coxoto/3dprint-x/non-print-parts/配件采购清单v3.0.xlsx

 | 零件 | 数量 | 备注 | 购买链接 | 单价 | 总价
型材 | 欧标2040V槽 8cm | 2 | 打孔情况查图片 | https://detail.tmall.com/item.htm?id=645296818131 |  | 40
 | 欧标2040V槽 14cm | 1 | 打孔情况查图片
 | 欧标2040V槽 16cm | 3 | 打孔情况查图片
 | 欧标2020V槽 16cm | 1 | 打孔情况查图片
 | 欧标2020V槽 8cm | 1
 |  |  |  |  |  | 0
型材配件 | 欧标2040V槽 内置角槽 | 2 |  | https://detail.tmall.com/item.htm?id=619268994329 | 1.3 | 2.6
 | 欧标2040V槽 带突起90度直角连接件 | 1 |  | https://detail.tmall.com/item.htm?id=619270997246 | 2 | 2
 |  |  |  |  |  | 0
线轨 | mgn12 轨道 25cm | 1 |  | https://item.taobao.com/item.htm?id=570924265589 | 21 | 21
 | mgn9 轨道 25cm | 3 |  |  | 21 | 63
 | 滑块 mgn12c | 1 |  |  | 15 | 15
 | 滑块 mgn 9c | 2 |  |  | 14 | 28
 | 滑块 mgn 9h | 1 |  |  | 16 | 16
 |  |  |  |  |  | 0
3d打印机专用 | 同步带 GT2-6mm 2米 | 1 | 61cm + 62cm | https://item.taobao.com/item.htm?id=570390971772 | 4.55 | 4.55
 | 加热棒 | 1 | 12V50W出口版 | https://item.taobao.com/item.htm?id=570370525400 | 5.65 | 5.65
 | 温感（3950热头打印头热床测温电阻） | 1 | 1米线长 xh2.54端子（28号线） | https://item.taobao.com/item.htm?id=570755267450 | 2 | 2
 | 铁氟龙管（1米） | 1 | 乳白色2*4(1.75mm) | https://item.taobao.com/item.htm?id=570795285538 | 1.2 | 1.2
 | 带齿同步轮 | 2 | 普通版m3（20齿高16)内孔5mm | https://item.taobao.com/item.htm?id=570468538209 | 1.58 | 3.16
 | 喉管散热片 | 1 |  | https://item.taobao.com/item.htm?id=594763596247 | 3.5 | 3.5
 | 喉管 | 1 |  | https://item.taobao.com/item.htm?id=601375968132 | 1.8 | 1.8
 | 加热块 | 1 |  | https://item.taobao.com/item.htm?id=570977277989 | 1.7 | 1.7
 | 喷嘴 | 1 | 0.3/1.75mm | https://item.taobao.com/item.htm?id=570346885706 |  | 0
 | 气动直通快接头 | 1 | PC4-01带蓝色卡扣（直通） | https://item.taobao.com/item.htm?id=572400928067 | 0.74 | 0.74
 | 黄色强力弹簧 | 4 |  | https://item.taobao.com/item.htm?id=587615069560 | 0.84 | 3.36
 | x支架 | 1 | 热床支架不带滑轮 | https://item.taobao.com/item.htm?id=646674554829 | 31.8 | 31.8
 | 热床带线带温感 | 1 | 150*150热床12V带线带螺丝 | https://item.taobao.com/item.htm?id=609361349866 | 30.8 | 30.8
 | 法兰轴承（当惰轮） | 4 | F623ZZ（3*10*4） | https://item.taobao.com/item.htm?id=574092180169 | 0.75 | 3
 | Titan泰坦挤出机 | 1 | 不带电机 | https://item.taobao.com/item.htm?id=576967896210 | 19 | 19
 | 弹性联轴器 | 1 | 5mm*8mm*25mm | https://item.taobao.com/item.htm?id=570564051068 | 2.6 | 2.6
 | 丝杆+螺母 | 1 | 250mm（丝杆+螺母） | https://item.taobao.com/item.htm?id=573812002249 | 7.9 | 7.9
 | 微动开关 限位开关 | 1 | 【记得买个三孔xh2.54的线】 | https://item.taobao.com/item.htm?id=572130975483 | 0.3 | 0.3
 | 橡皮脚垫 | 4 | 20*14*17 | https://detail.tmall.com/item.htm?id=592188833539 | 0.25 | 1
 |  |  |  |  |  | 0
风扇 | 3010风扇 | 1 | 12V液压轴承8000转速[居中款XH2.54插头] | https://item.taobao.com/item.htm?id=611631396007 |  | 0
 | 3010涡轮风扇 | 1 | 含油轴承12V 2线(XH2.54插头) | https://item.taobao.com/item.htm?id=612218746821 | 6 | 6
 |  |  |  |  |  | 0
其它大件 | Makerbase MKS Gen-L 主板 | 1 | MKS GEN_L 2.1 | https://item.taobao.com/item.htm?id=543608919100 | 100 | 100
 | 12864 屏幕 | 1 |  | https://item.taobao.com/item.htm?id=651635691903 | 46 | 46
 | 电机驱动2209 | 2 |  | https://item.taobao.com/item.htm?id=596848801805 | 18 | 36
 | 电机驱动2208 | 2 |  | https://item.taobao.com/item.htm?id=560642031320 | 14 | 28
 | 42步进电机 | 4 |  | https://item.taobao.com/item.htm?id=608923027875 | 29 | 116
 | 12v开关电源 | 1 | S-200-12 / 12v 16.5A | https://detail.tmall.com/item.htm?id=613571195909 | 36 | 36
 | 插座带开关 | 1 | AC-01A三脚带灯 | https://item.taobao.com/item.htm?id=45556198869 | 2.5 | 2.5
 |  |  |  |  | 总计 | 682.16
其它耗材 | m3 沉头螺丝 32mm | 4
 | m3 黄铜滚花螺母 5mm高 5mm直径 | 20
 | m3 22mm | 2
 | m3 螺母 | 50+
 | m3 t型螺母 | 50+
 | m3 滑块螺母 | 50+
 | m3 6mm | 50+
 | m3 8mm | 50+
 | m3 12mm | 50+
 | m3 10mm | 50+
 | m3 金属垫片
 | m3 尼龙垫片
 | m3 尼龙柱 2mm | 4
 | m5 10mm | 8
 | m5 15mm | 3
 | 一些延长的电线
 | 热缩管
 | 耐热胶带
 | 隔热海绵
 | 打印板（普通/PEI/玻璃/晶格）
