coxoto/3dprint-x/non-print-parts/4020-holes.jpg

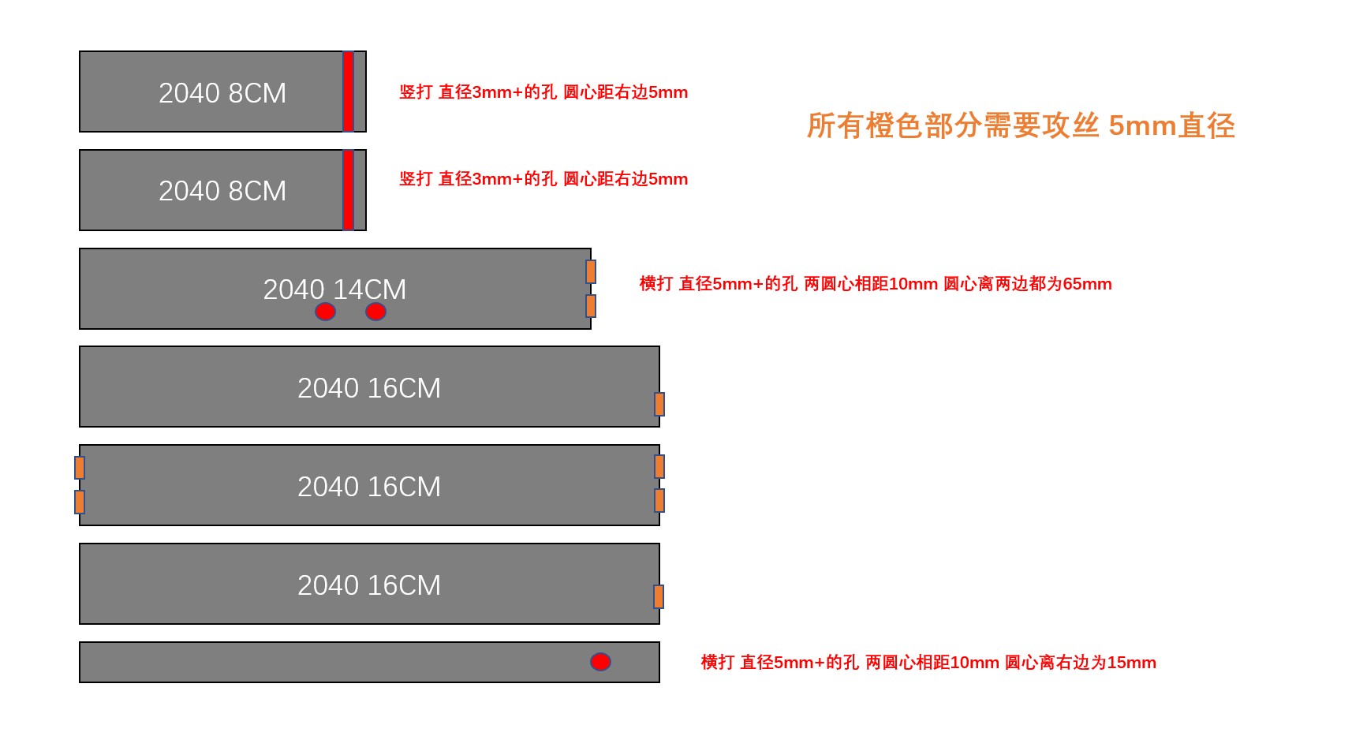
non-print-parts/4020-holes.jpg
