coxoto/3dprint-x/stl/1x main-heat-sink-support.stl

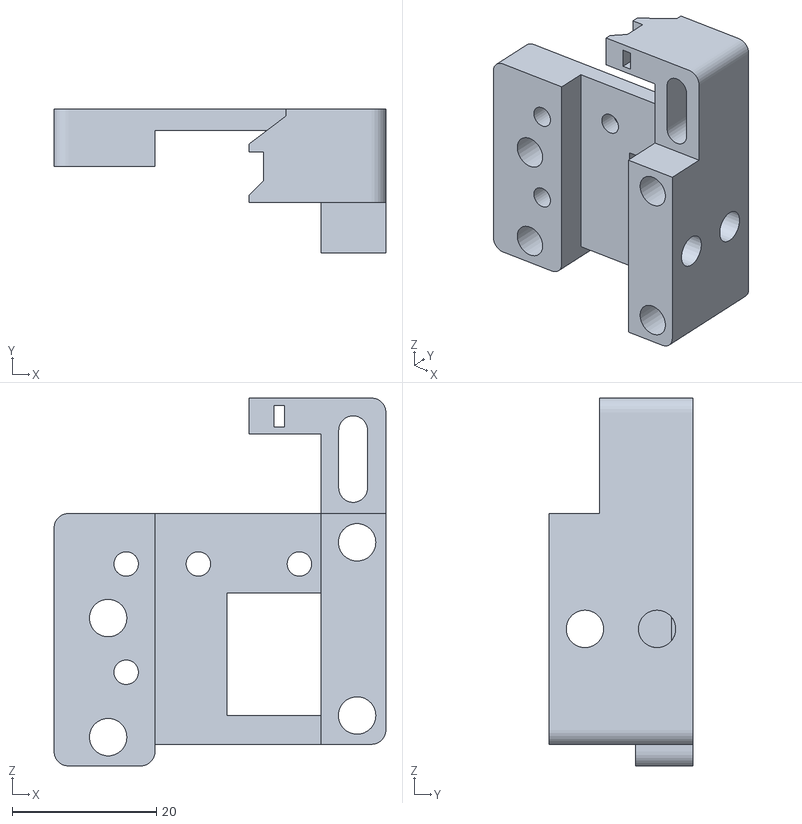
[picture p7: CAD file, 2021-11-16]
stl/1x main-heat-sink-support.stl
46.0 x 20.0 x 51.0
