coxoto/3dprint-x/stl/1x main-support.stl

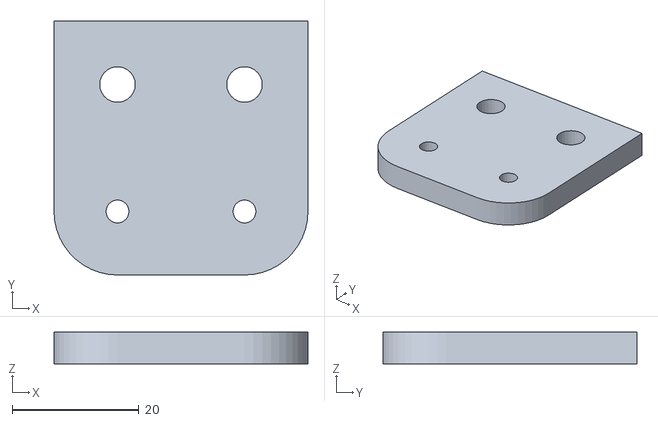
[picture p8: CAD file, 2021-11-16]
stl/1x main-support.stl
40.0 x 40.0 x 5.00
