coxoto/3dprint-x/design/00-全组装图.FCStd

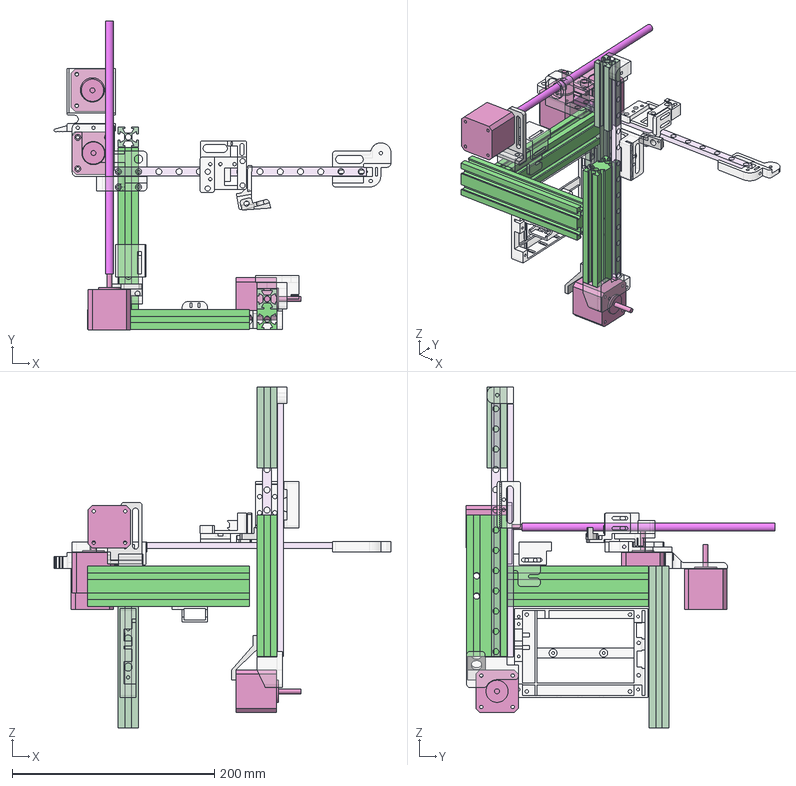
[picture p9: CAD file, 2021-11-23]
design/00-全组装图.FCStd
333.0 x 305.2 x 336.8 mm
x轴末端
小滑轨
42电机
挤出机支架
42电机002
mid主支架
mid主支架02
冷却支架02
冷却支架01
x-middle
xz核心件
2040 竖
y轴4线连接器
z下端
z轴限位架子
z电机板子
丝杆
42电机001
2040 140mm
小滑轨001
小滑轨002
Y电机支架
Y电机支架反面
new_y_end
中部热床支架支架
42电机003
主板架、
