coxoto/3dprint-x/stl/1x x-core.stl

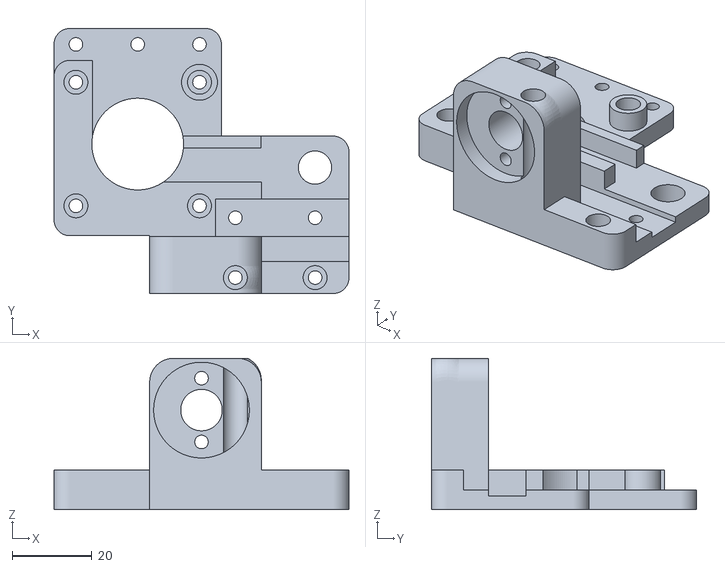
[picture p10: CAD file, 2021-11-23]
stl/1x x-core.stl
74.0 x 66.5 x 38.0
