coxoto/3dprint-x/stl/small-parts/4x big-knob.stl

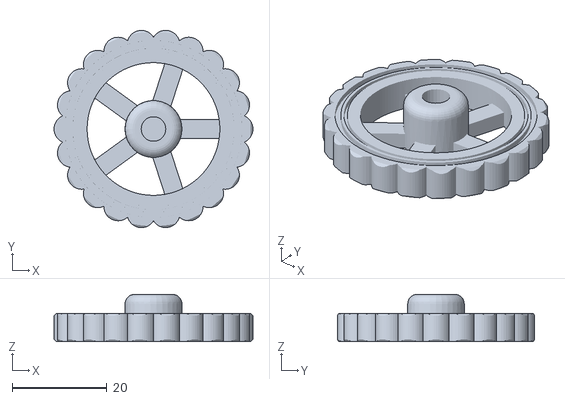
[picture p11: CAD file, 2021-11-23]
stl/small-parts/4x big-knob.stl
42.0 x 41.6 x 10.0
