coxoto/3dprint-x/design/00-其它小零件.FCStd

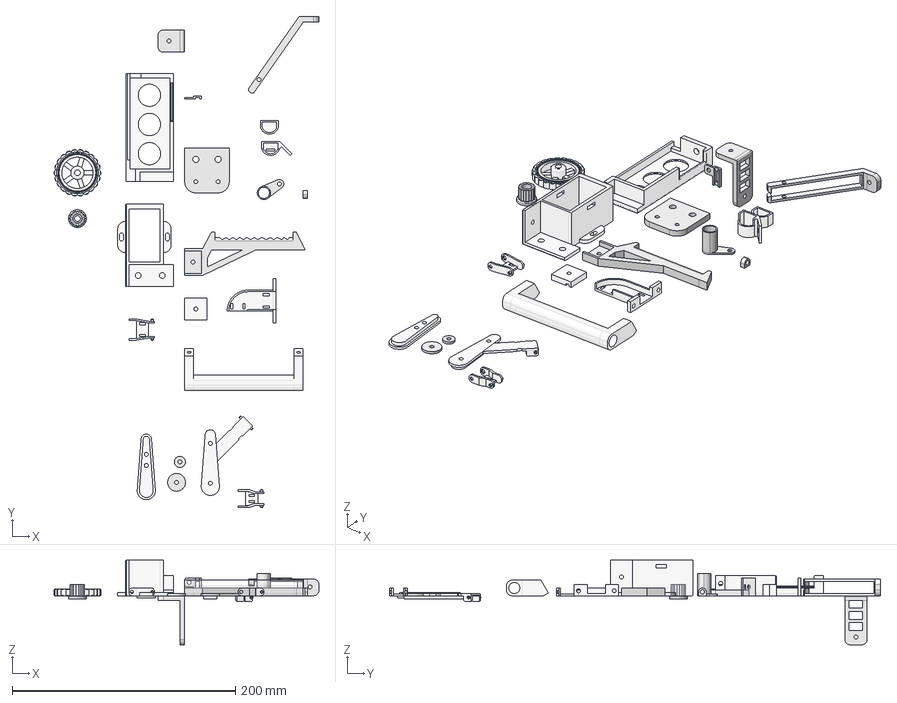
[picture p12: CAD file, 2021-11-23]
design/00-其它小零件.FCStd
237.3 x 439.8 x 76.0 mm
电源保护
开关盒
4孔骨架
三角料架
加固支架
小线槽
铁丝导料支架
尾巴线01
尾巴线02
灯管架01
灯管架02
新把手
导料滚轮支架
大链条（弃用）
主板转弯线束
大旋钮
小旋钮
热床卡口-零件01
热床卡口-零件02
8mm小圆
5mm小圆
小链条
热床卡口测试片
