coxoto/3dprint-x/stl/1x y-motor-support-2.stl

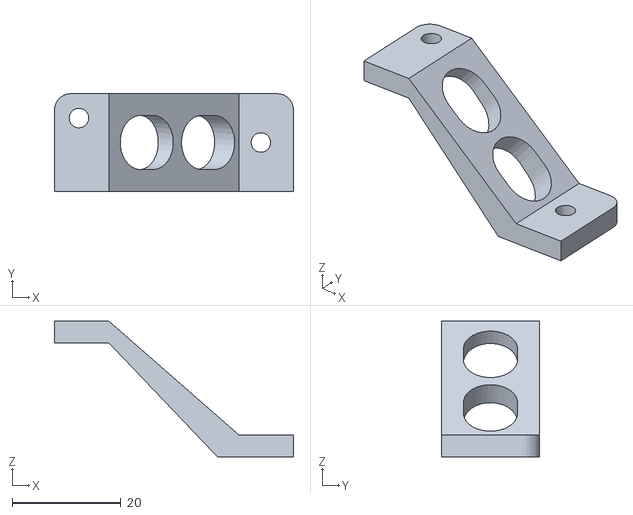
[picture p13: CAD file, 2021-11-18]
stl/1x y-motor-support-2.stl
44.0 x 18.0 x 25.0
