coxoto/3dprint-x/stl/small-parts/1x bed-middle-small-part.stl

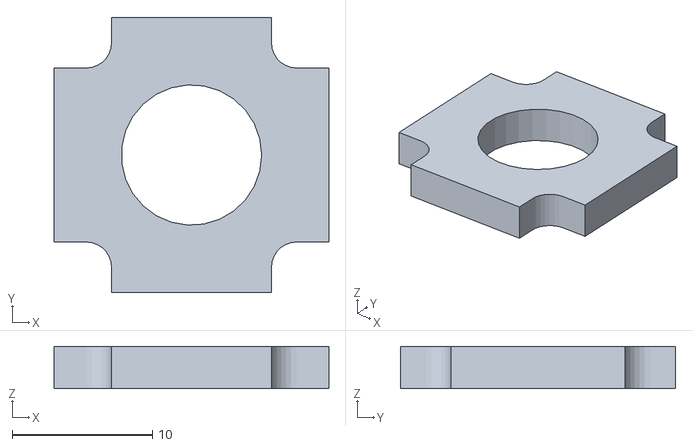
[picture p14: CAD file, 2021-11-16]
stl/small-parts/1x bed-middle-small-part.stl
19.6 x 19.6 x 3.00
