coxoto/3dprint-x/stl/1x x-mid.stl

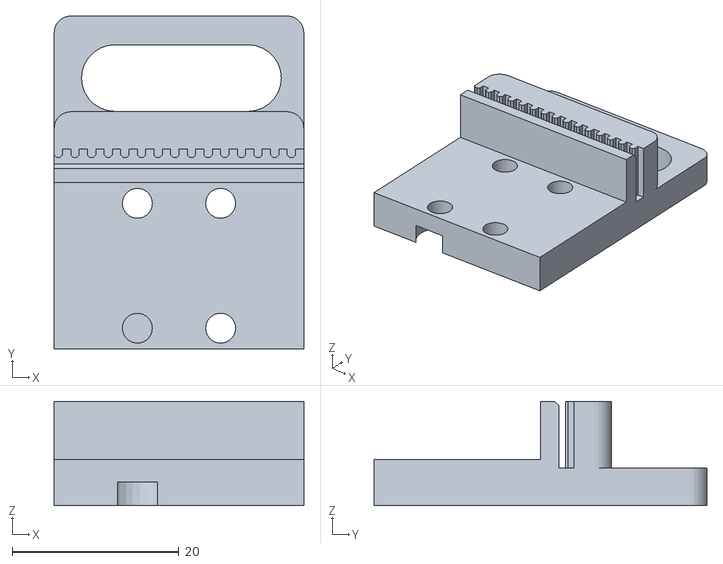
[picture p15: CAD file, 2021-11-18]
stl/1x x-mid.stl
30.0 x 40.0 x 12.5
