coxoto/3dprint-x/stl/small-parts/8x small-chain.stl

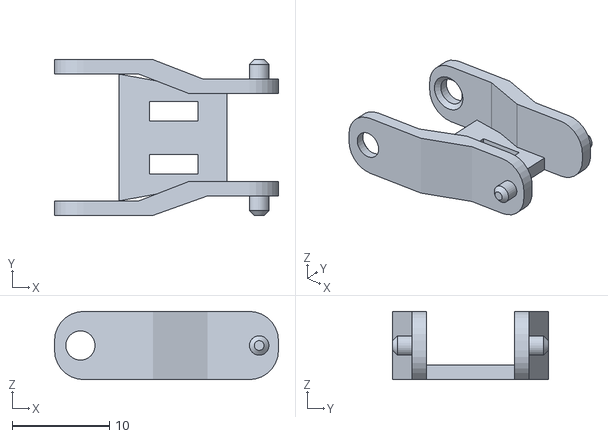
[picture p16: CAD file, 2021-11-16]
stl/small-parts/8x small-chain.stl
23.0 x 16.0 x 7.00
