coxoto/3dprint-x/stl/1x mother-board-support.stl

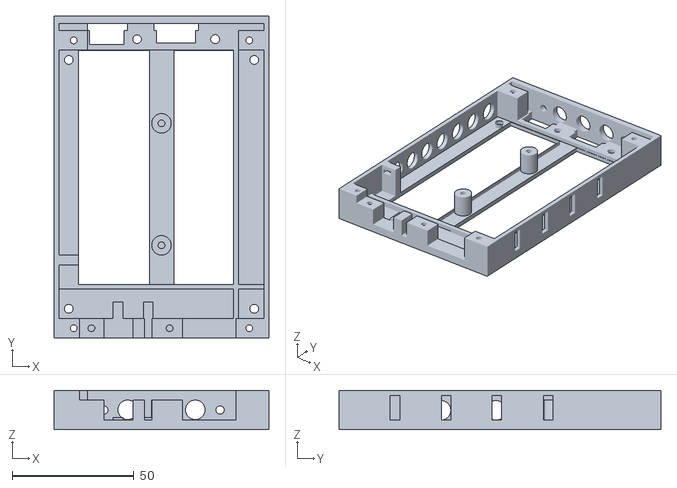
[picture p17: CAD file, 2021-11-16]
stl/1x mother-board-support.stl
88.0 x 132.0 x 16.0
