coxoto/3dprint-x/stl/small-parts/1x bed-wire-harness-support-2.stl

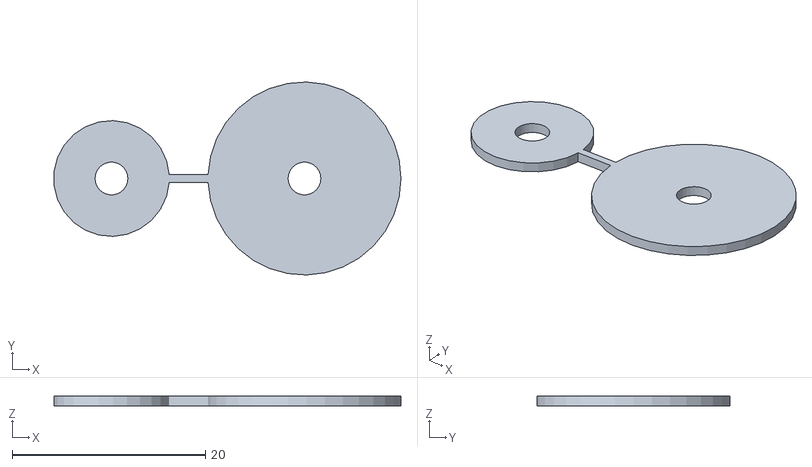
[picture p18: CAD file, 2021-11-16]
stl/small-parts/1x bed-wire-harness-support-2.stl
36.0 x 20.0 x 1.00
