coxoto/3dprint-x/stl/1x z-core-support.stl

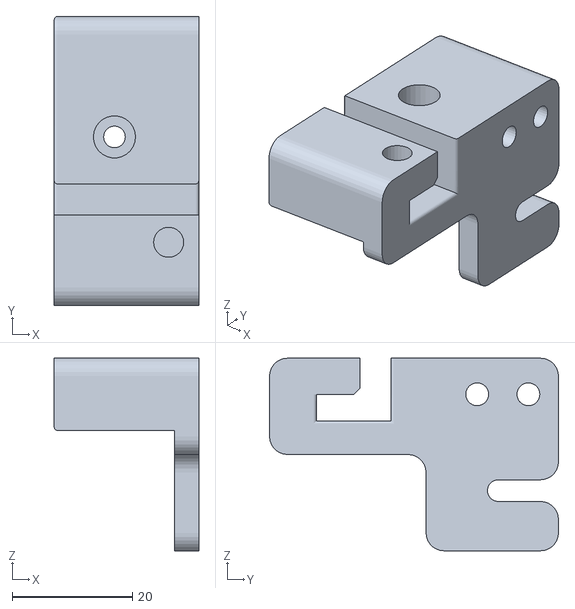
[picture p19: CAD file, 2021-11-16]
stl/1x z-core-support.stl
24.0 x 48.0 x 32.0
