coxoto/3dprint-x/stl/small-parts/2x big-x.stl

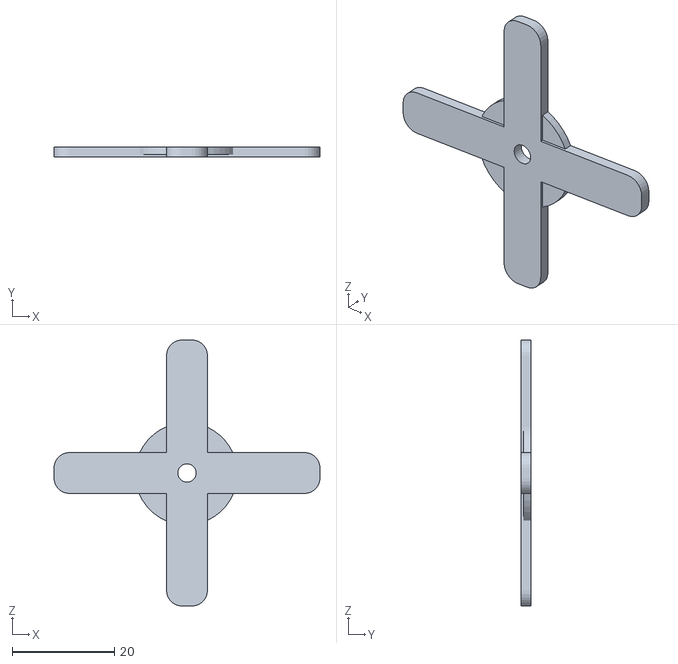
[picture p20: CAD file, 2021-11-16]
stl/small-parts/2x big-x.stl
52.0 x 2.00 x 52.0
