coxoto/3dprint-x/stl/1x 18640-support.stl

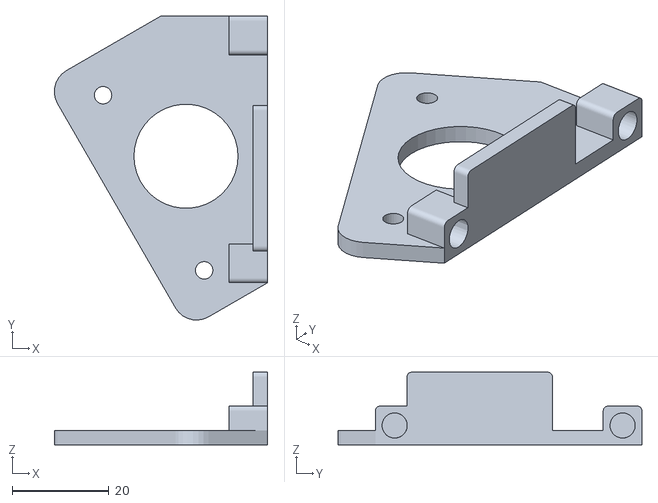
[picture p21: CAD file, 2021-11-16]
stl/1x 18640-support.stl
44.0 x 62.7 x 15.0
