coxoto/3dprint-x/stl/small-parts/2x powerbox-support.stl

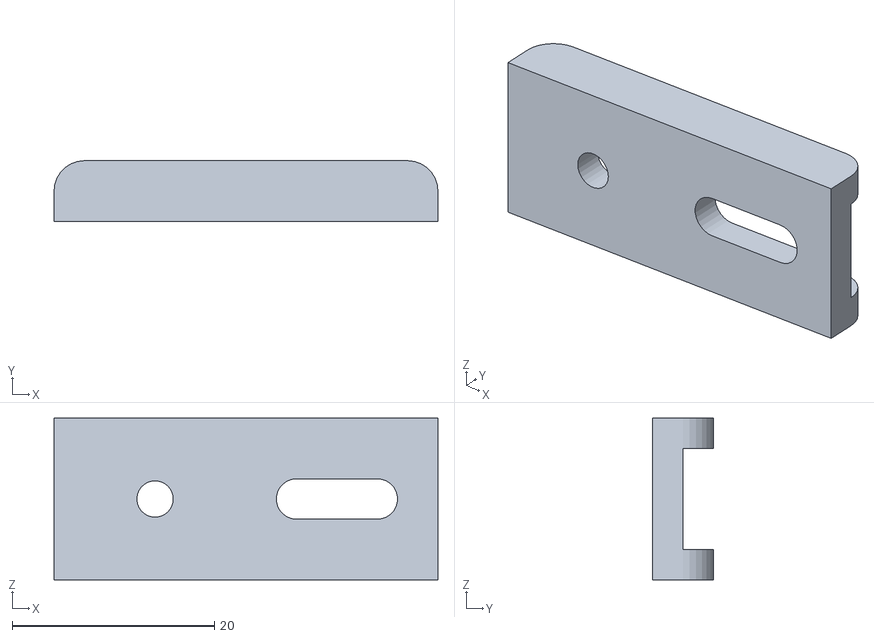
[picture p22: CAD file, 2021-11-16]
stl/small-parts/2x powerbox-support.stl
38.0 x 6.00 x 16.0
