coxoto/3dprint-x/stl/1x switch-box.stl

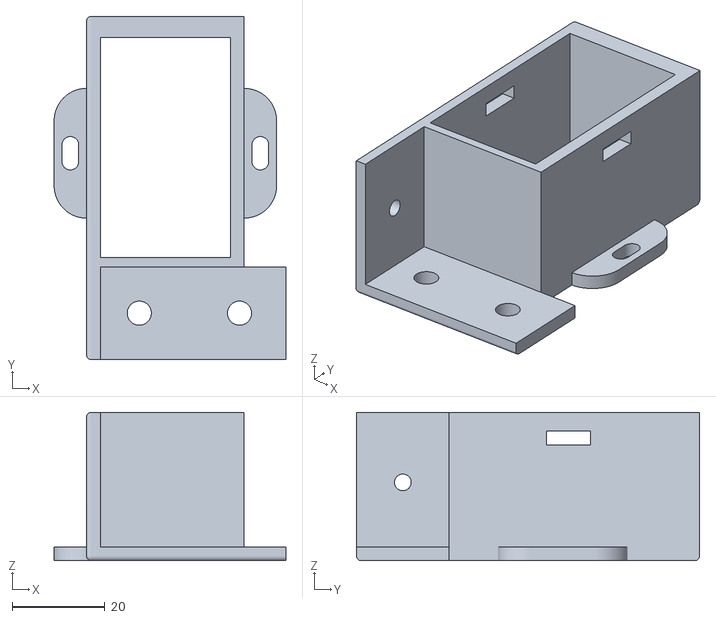
[picture p23: CAD file, 2021-11-16]
stl/1x switch-box.stl
50.0 x 74.0 x 32.0
