coxoto/3dprint-x/stl/small-parts/1x big-wire-harness-support.stl

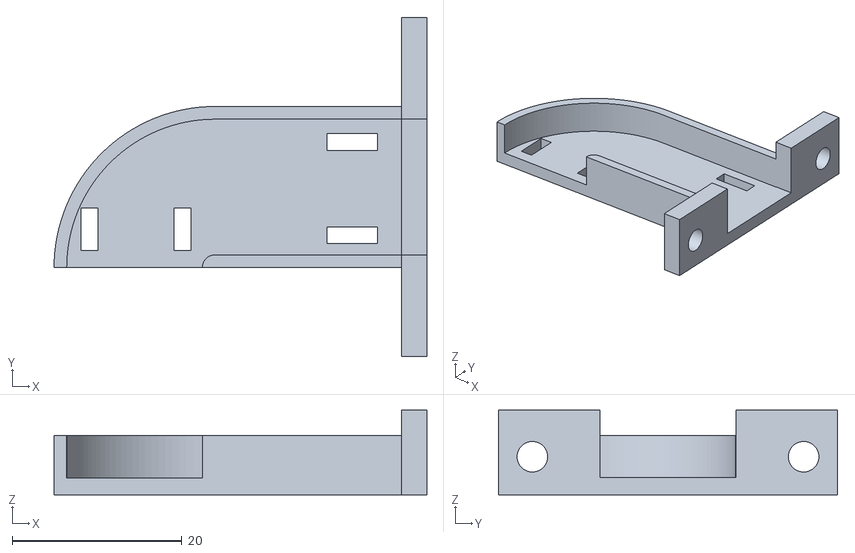
[picture p24: CAD file, 2021-11-16]
stl/small-parts/1x big-wire-harness-support.stl
44.0 x 40.0 x 10.0
