coxoto/3dprint-x/stl/1x extruder-support.stl

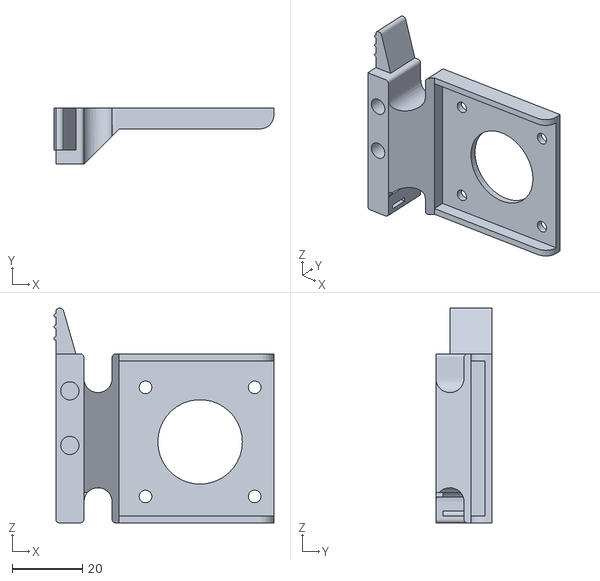
[picture p25: CAD file, 2021-11-16]
stl/1x extruder-support.stl
62.5 x 16.0 x 61.0
