coxoto/3dprint-x/stl/small-parts/1x small-l.stl

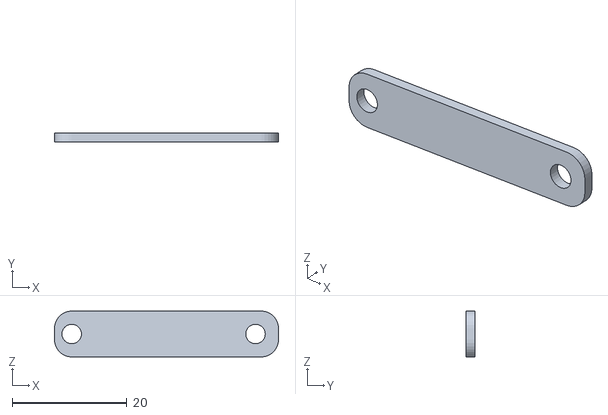
[picture p26: CAD file, 2021-11-16]
stl/small-parts/1x small-l.stl
39.0 x 1.50 x 8.00
