coxoto/3dprint-x/stl/1x Y-connect-support.stl

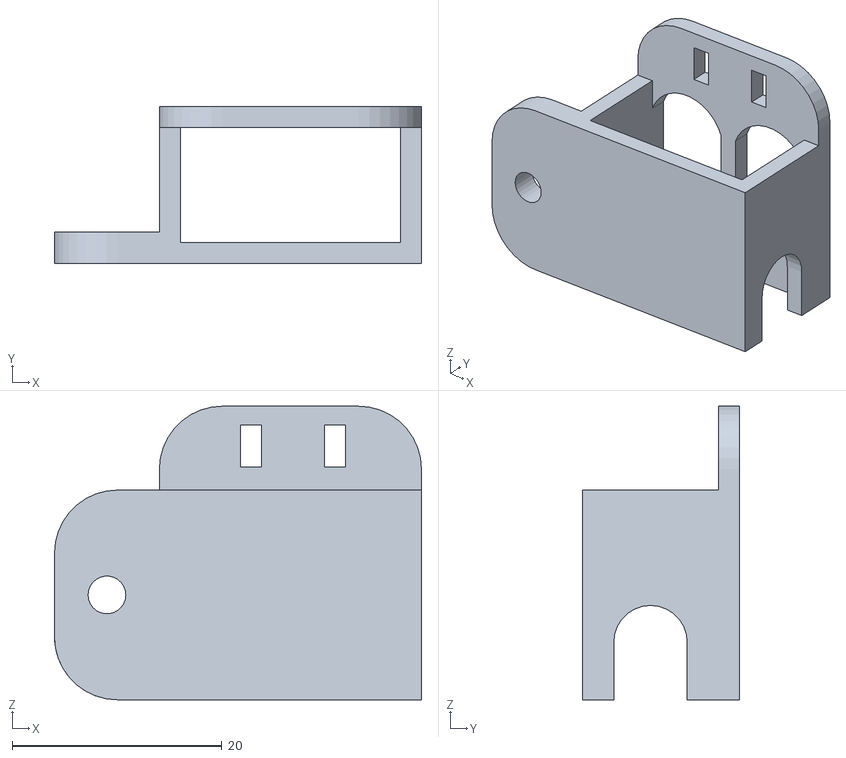
[picture p27: CAD file, 2021-11-16]
stl/1x Y-connect-support.stl
35.0 x 15.0 x 28.0
