coxoto/3dprint-x/stl/small-parts/1x small-knob.stl

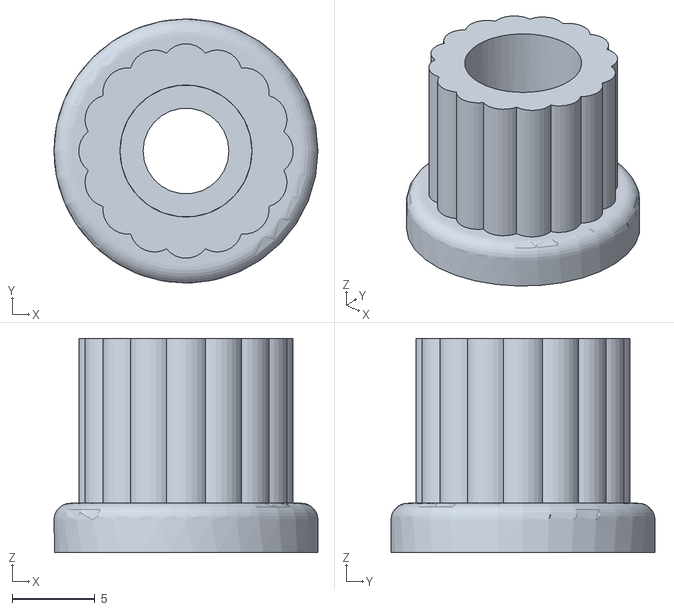
[picture p28: CAD file, 2021-11-16]
stl/small-parts/1x small-knob.stl
16.0 x 16.0 x 13.0
