coxoto/3dprint-x/stl/1x filament-guide.stl

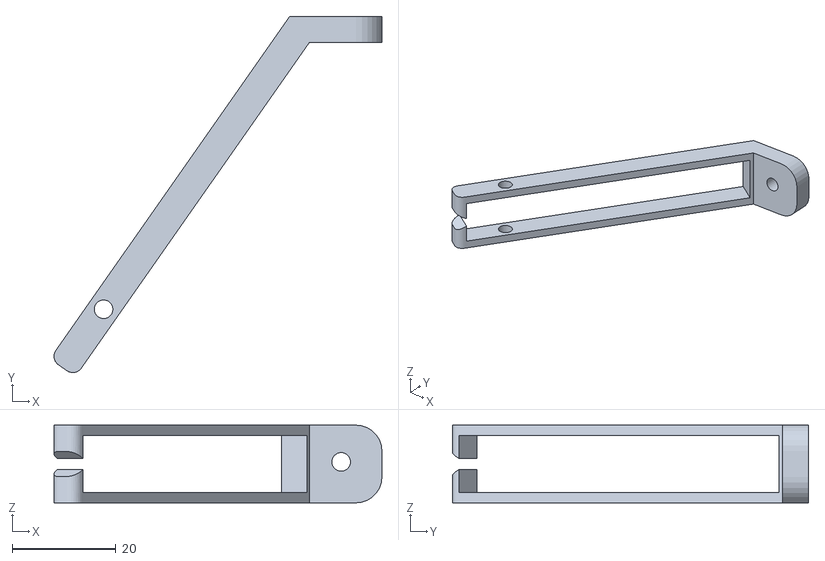
[picture p29: CAD file, 2021-11-16]
stl/1x filament-guide.stl
63.3 x 68.8 x 15.0
