coxoto/3dprint-x/stl/small-parts/1x another-support.stl

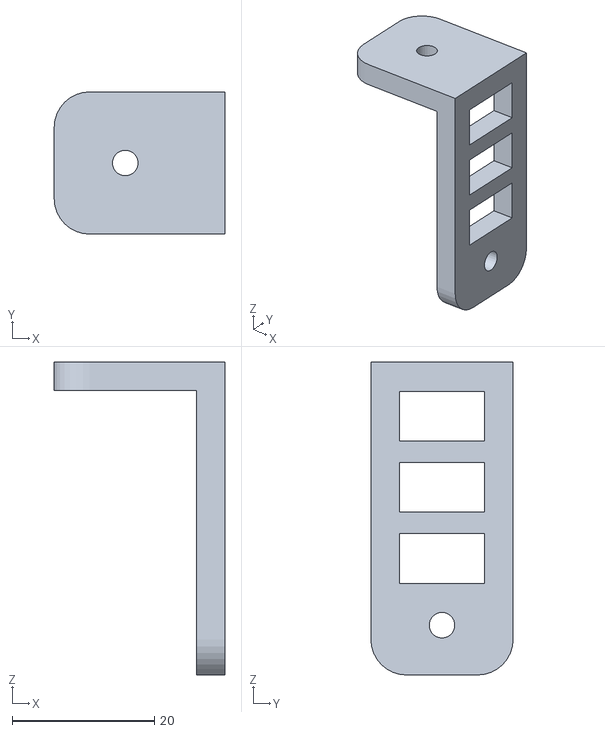
[picture p30: CAD file, 2021-11-16]
stl/small-parts/1x another-support.stl
24.0 x 20.0 x 44.0
