coxoto/3dprint-x/stl/1x y-end.stl

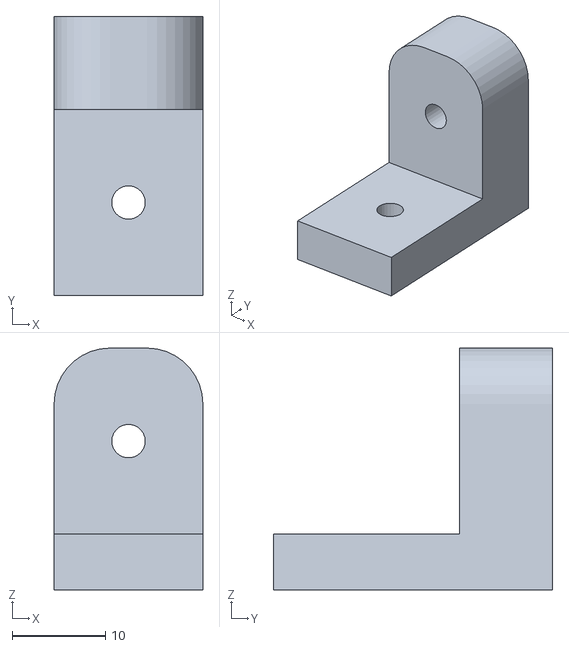
[picture p31: CAD file, 2021-11-16]
stl/1x y-end.stl
16.0 x 30.0 x 26.0
