coxoto/3dprint-x/stl/small-parts/1x tail-wire-support.stl

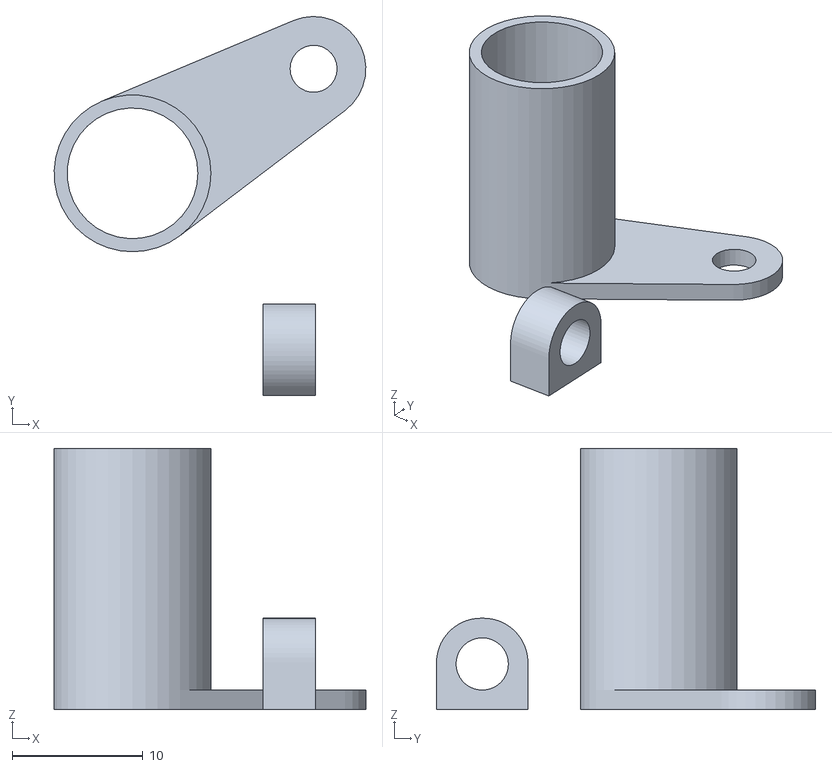
[picture p32: CAD file, 2021-11-16]
stl/small-parts/1x tail-wire-support.stl
23.8 x 29.0 x 20.0
