coxoto/3dprint-x/stl/1x triangle-filament-shelf.stl

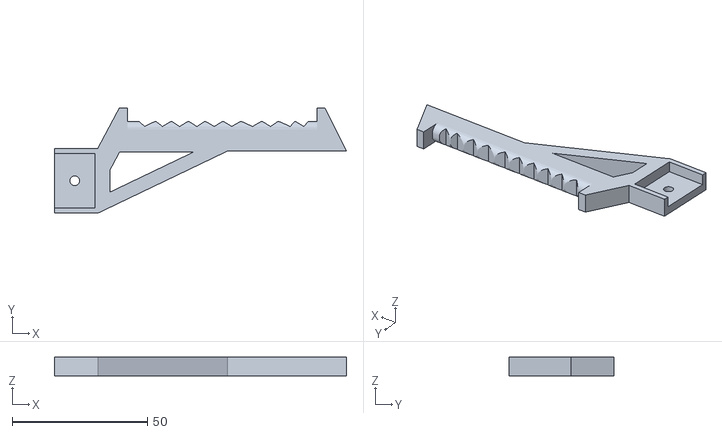
[picture p33: CAD file, 2021-11-16]
stl/1x triangle-filament-shelf.stl
108.0 x 39.0 x 7.00
