coxoto/3dprint-x/stl/small-parts/1x-filament-guide-2.stl

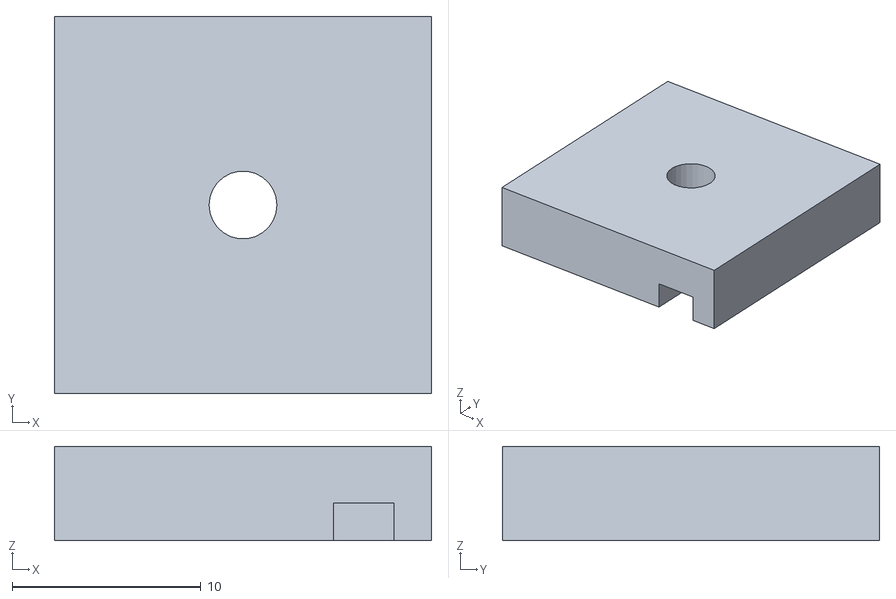
[picture p34: CAD file, 2021-11-16]
stl/small-parts/1x-filament-guide-2.stl
20.0 x 20.0 x 5.00
