coxoto/3dprint-x/stl/1x z-motor-support.stl

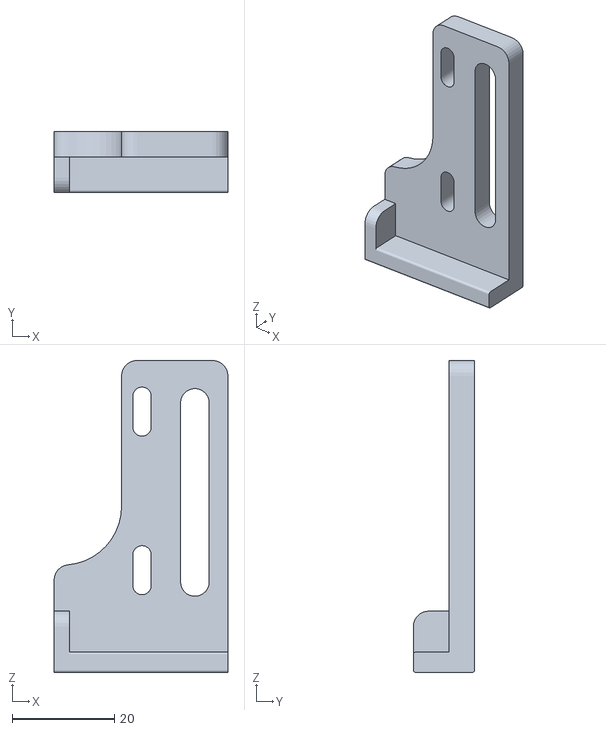
[picture p35: CAD file, 2021-11-16]
stl/1x z-motor-support.stl
34.0 x 12.0 x 61.0
