coxoto/3dprint-x/stl/small-parts/1x small-wire-support.stl

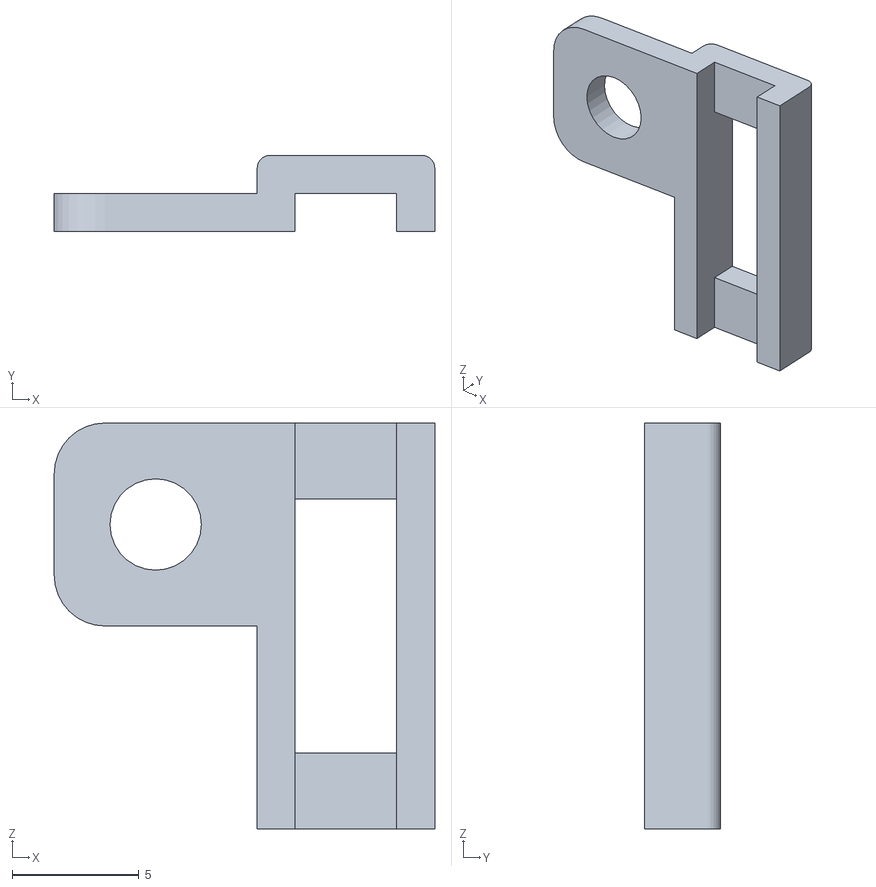
[picture p36: CAD file, 2021-11-16]
stl/small-parts/1x small-wire-support.stl
15.0 x 3.00 x 16.0
