coxoto/3dprint-x/stl/1x power-box.stl

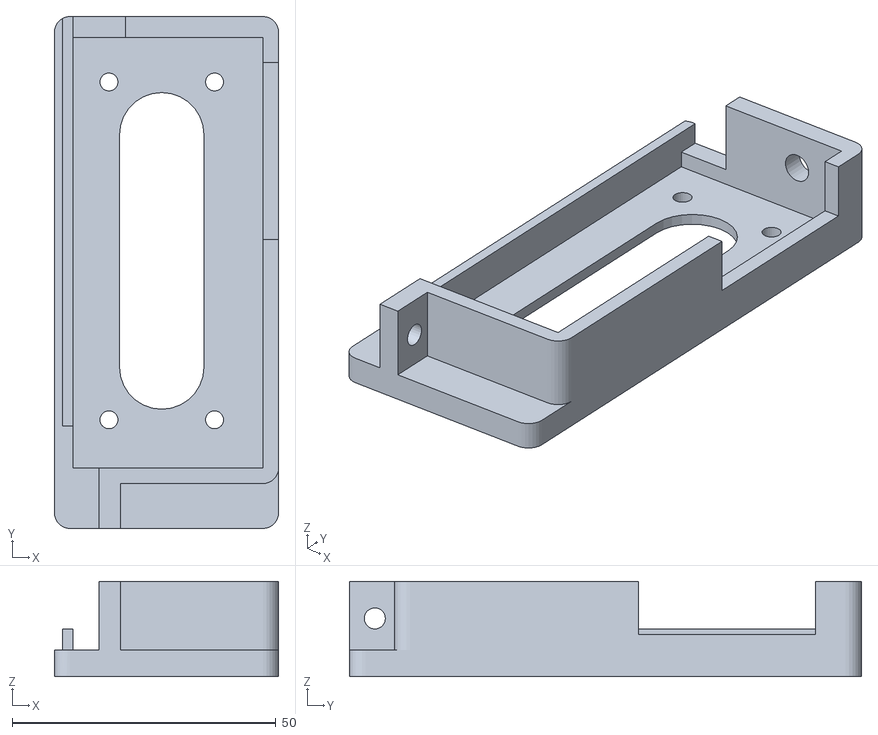
[picture p37: CAD file, 2021-11-16]
stl/1x power-box.stl
42.5 x 97.0 x 18.0
