coxoto/3dprint-x/stl/small-parts/1x bed-wire-harness-support.stl

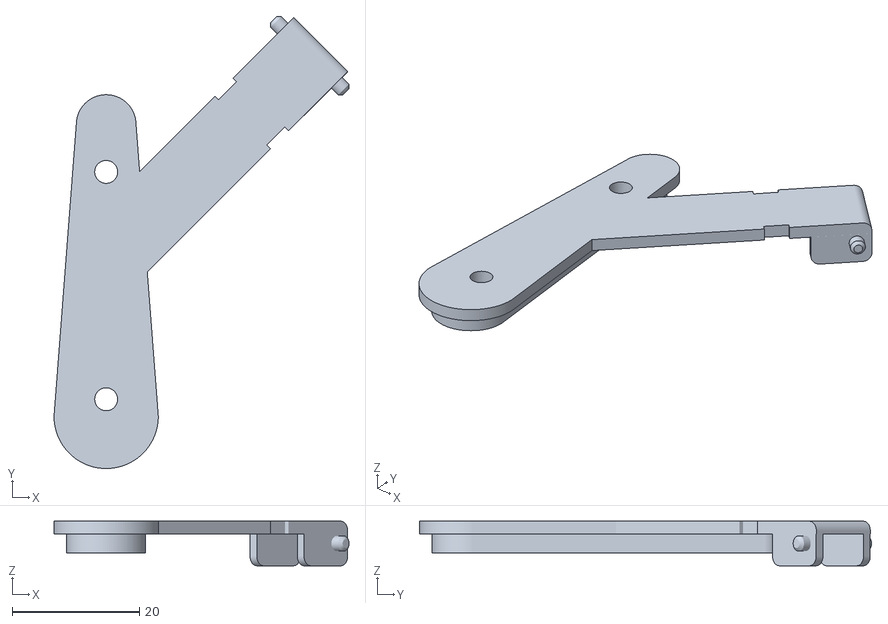
[picture p38: CAD file, 2021-11-16]
stl/small-parts/1x bed-wire-harness-support.stl
46.4 x 71.1 x 7.00
