coxoto/3dprint-x/stl/small-parts/1x light-support.stl

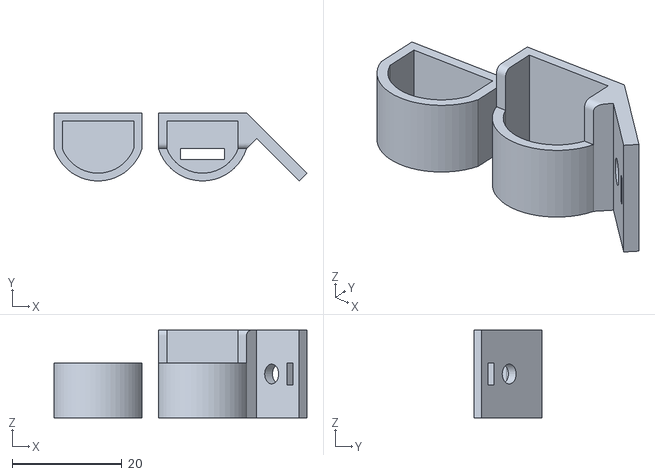
[picture p39: CAD file, 2021-11-16]
stl/small-parts/1x light-support.stl
46.0 x 12.4 x 16.0
