coxoto/3dprint-x/stl/1x y-motor-support.stl

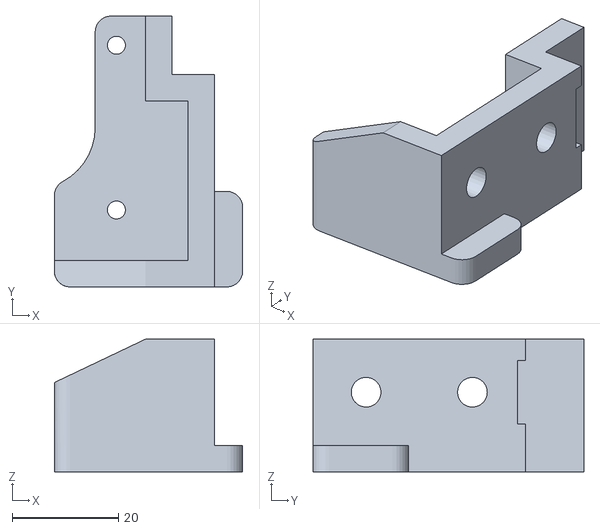
[picture p40: CAD file, 2021-11-16]
stl/1x y-motor-support.stl
35.5 x 51.0 x 25.0
