coxoto/3dprint-x/stl/1x turbo-fan-support.stl

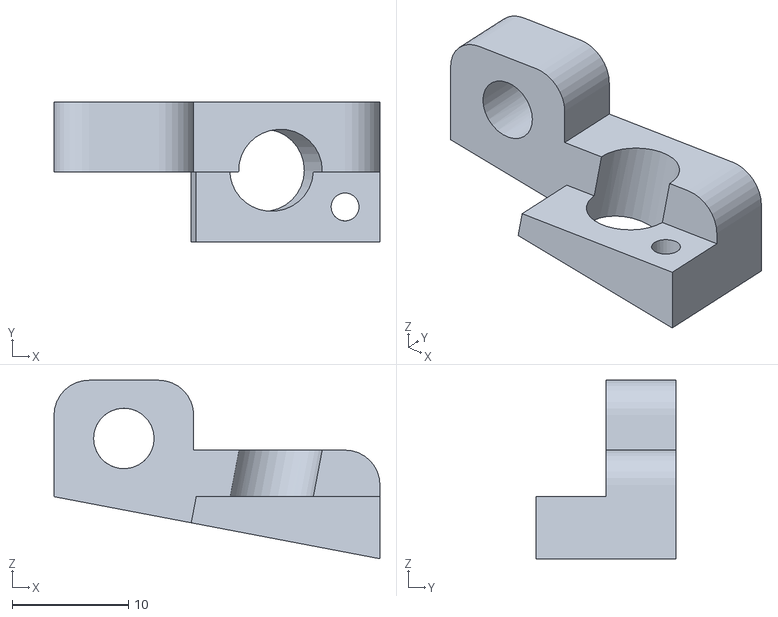
[picture p41: CAD file, 2021-11-16]
stl/1x turbo-fan-support.stl
28.0 x 12.0 x 15.3
