coxoto/3dprint-x/stl/1x y-mid.stl

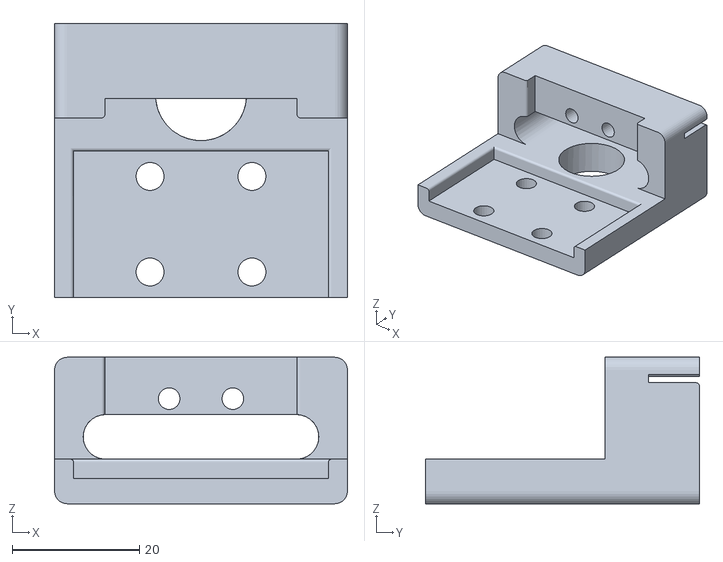
[picture p42: CAD file, 2021-11-16]
stl/1x y-mid.stl
46.0 x 43.0 x 23.0
