coxoto/3dprint-x/stl/1x limit-switch-support.stl

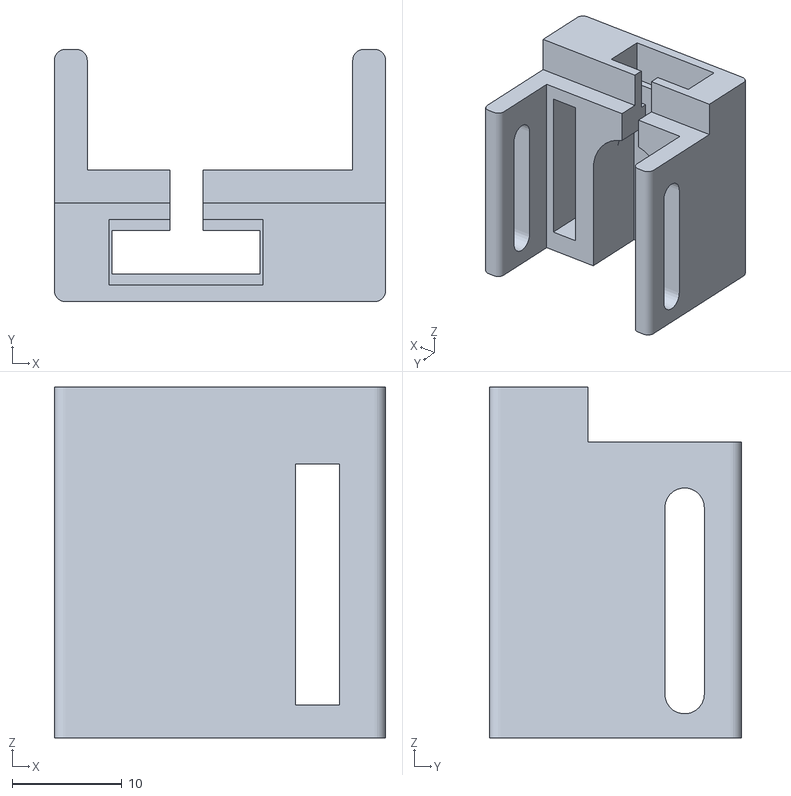
[picture p43: CAD file, 2021-11-16]
stl/1x limit-switch-support.stl
30.2 x 23.0 x 32.0
