coxoto/3dprint-x/stl/1x x-end.stl

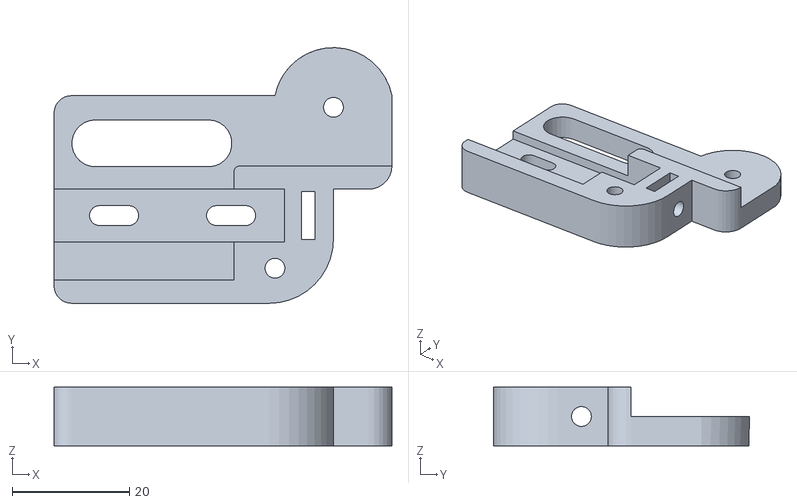
[picture p44: CAD file, 2021-11-16]
stl/1x x-end.stl
57.8 x 43.7 x 10.0
