coxoto/3dprint-x/stl/1x handle.stl

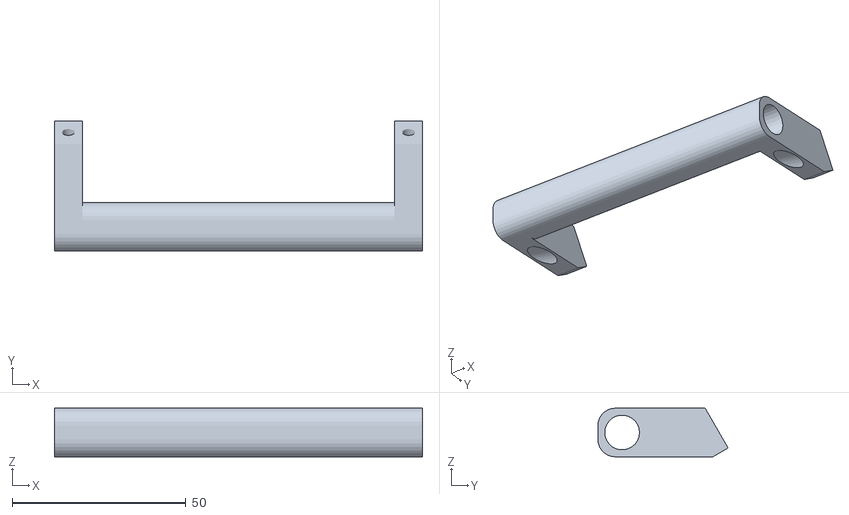
[picture p45: CAD file, 2021-11-16]
stl/1x handle.stl
106.0 x 37.5 x 14.0
