coxoto/3dprint-x/stl/1x turbo-fan-support-2.stl

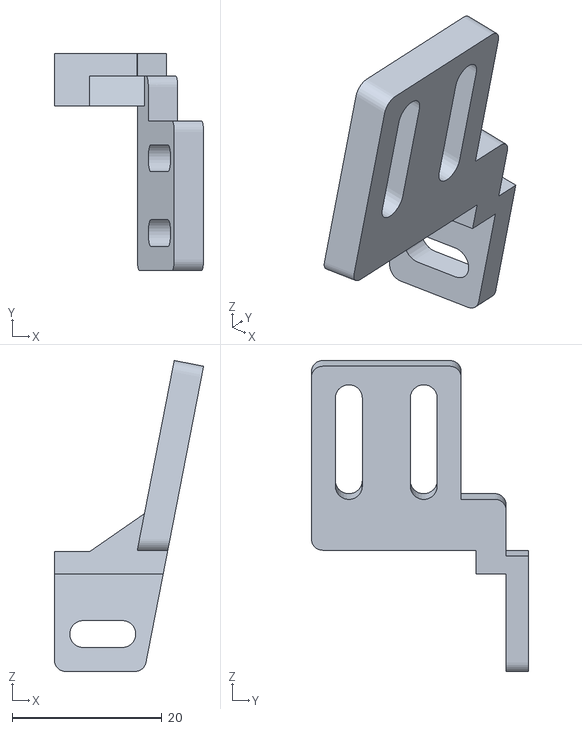
[picture p46: CAD file, 2021-11-16]
stl/1x turbo-fan-support-2.stl
19.9 x 29.0 x 41.5
