coxoto/3dprint-x/(commit log)

2021-11-16 create project
    [00-最终版-x轴-xz连接件-xmid组件-x末端组件.FCStd, 00001-新设计钢丝架子.stl, 18640固定.stl, 1mm垫片.stl, 1x 40 电源保护壳-v2.stl, 1x 60 xz轴核心件.stl, 1x 60 x轴mid.stl, 1x 60 y轴mid-v2.stl]
2021-11-16 add board
    [最终版主板架.stl]
2021-11-16 rename to English
    [00-最终版-x轴-xz连接件-xmid组件-x末端组件.FCStd, 1mm垫片.stl, 1x 18640-support.stl, 1x Y-connect-support.stl, 1x another-support.stl, 1x bed-middle-small-part.stl, 1x bed-wire-harness-support-2.stl, 1x bed-wire-harness-support.stl]
2021-11-18 add design and update some stl
    [00-最终版-e轴-挤出机支架.FCStd, 00-最终版-e轴-滚轮导料架.FCStd, 00-最终版-x轴-xz连接件-xmid组件-x末端组件.FCStd, 00-最终版-x轴-主板转接弯头-大链条.FCStd, 00-最终版-x轴-喷吐组件-中间件.FCStd, 00-最终版-x轴-喷吐组件-模型冷却风扇支架.FCStd, 00-最终版-y轴-y轴4线连接器.FCStd, 00-最终版-y轴-热床支架卡口和垫片-链条.FCStd]
2021-11-23 new design
    [00-全组装图.FCStd, 00-其它小零件.FCStd, 00-最终版-e轴-挤出机支架.FCStd, 00-最终版-e轴-滚轮导料架.FCStd, 00-最终版-x轴-xz连接件-xmid组件-x末端组件.FCStd, 00-最终版-x轴-主板转接弯头-大链条.FCStd, 00-最终版-x轴-喷吐组件-中间件.FCStd, 00-最终版-x轴-喷吐组件-模型冷却风扇支架.FCStd]
2021-12-22 add non-print-parts list
    [机器人配件采购清单v3.0.xlsx]
2021-12-22 add pictures
    [机器人配件采购清单v3.0.xlsx, 配件采购清单v3.0.xlsx]
2021-12-22 rm old file
    [机器人配件采购清单v3.0.xlsx]
